Mutiur03/CSE-3106_IoT_2207093_2207096_2207097_2207120/(commit log)

2026-07-06 cleared everyhting, now will satrt on kinematic analysis
2026-07-13 Add support for additional joints (J5, J6) in robotic arm control
2026-07-13 Implement API for joint movement control and state retrieval
2026-09-02 Clean repo and rewrite README for submission
    Remove unrelated plain-Arduino test sketch, rename calibration
    sketches for clarity, and rewrite README to match actual firmware
    state (no IK yet), add group info, architecture, hardware/software,
    and setup docs.
